jdmytrva/PowerSupply-BatteryCheking-PS2403L-/Eagle board/PS TPS54340 Voltage CurrentRev2.brd

## EAGLE design Eagle board/PS TPS54340 Voltage CurrentRev2.brd (2019-05-19, an earlier design)

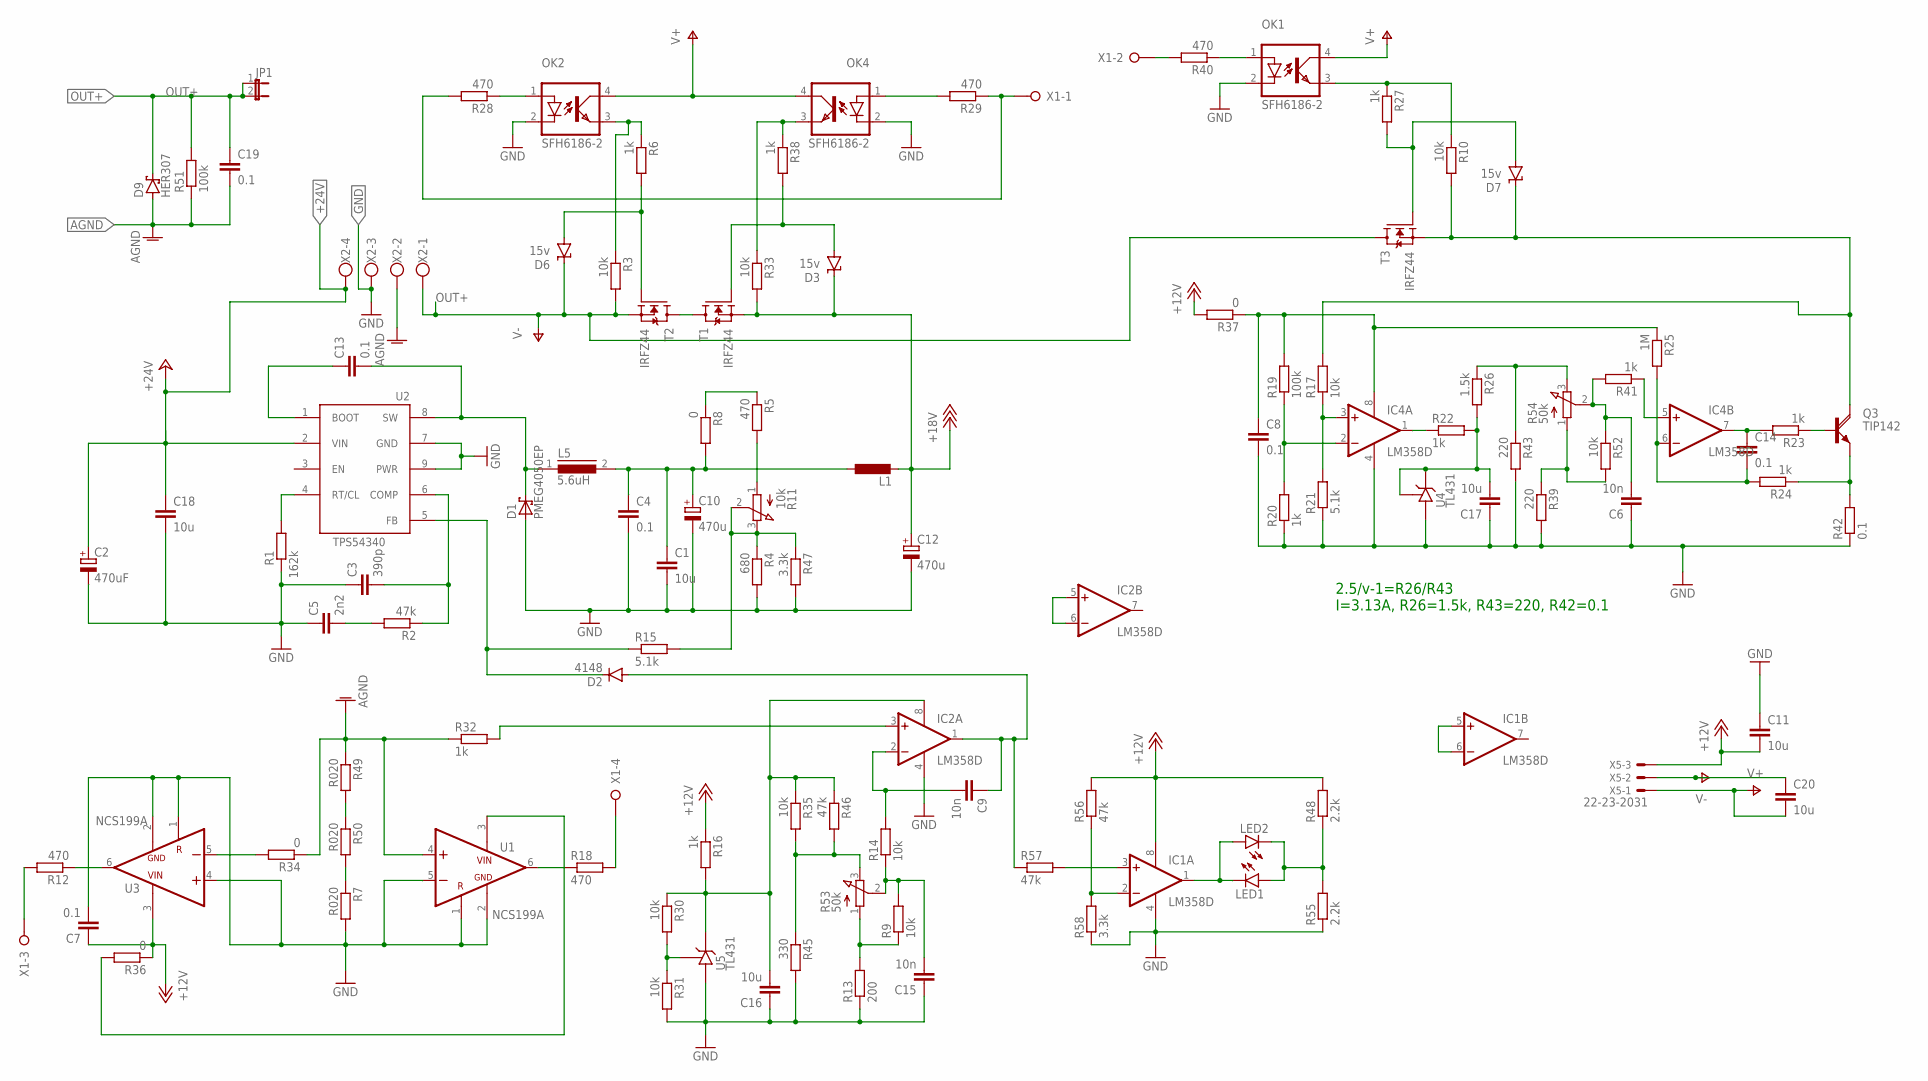
[picture p1: schematic PS TPS54340 Voltage CurrentRev2.sch]

Parts:
C1, C18: 10u; C1210
C2: 470uF; E5-10,5
C3: 390p; C0603K
C4, C8, C14: 0.1; C1206
C5: 2n2; C0603K
C6, C9, C15: 10n; C0603K
C7: 0.1; C0603K
C10, C12: 470u; E5-10,5
C11, C20: 10u; C1206
C13: 0.1; C102-043X133
C16, C17: 10u; C0603K
C19: 0.1; C150-054X183
D1: PMEG4050EP; SOD128
D2: 4148; SOD80C
D3, D6, D7: 15v; SMBJ
D9: HER307; CB429-17
IC1, IC2, IC4: LM358D; SO08
JP1: JP1E; JP1
L1: L-EU0207/5V; 0207/5V
L5: 5.6uH; DR125
LED1, LED2: LEDB152; Q62902-B152
OK1, OK2, OK4: SFH6186-2; SMD4-7
Q3: TIP142; SOT93
R1: 162k; R1206
R2, R46, R56, R57: 47k; R0603
R3, R9, R10, R30, R31, R33, R35, R52: 10k; R0603
R4: 680; R1206
R5: 470; R1206
R6, R16, R22, R27, R38: 1k; R0603
R7, R49, R50: R020; R1206
R8: 0; R0603
R11: 10k; 3RP/1610N
R12, R18, R28, R29, R40: 470; R0603
R13: 200; R0603
R14, R17: 10k; R1206
R15: 5.1k; R0603
R19: 100k; R1206
R20, R23, R24, R32, R41: 1k; R1206
R21: 5.1k; R1206
R25: 1M; R1206
R26: 1.5k; R0603
R34, R36, R37: 0; R1206
R39, R43: 220; R0603
R42: 0.1; 0414/15
R45: 330; R0603
R47: 3.3k; R1206
R48, R55: 2.2k; R0603
R51: 100k; 0207/15
R53, R54: 50k; 3RP/1610N
R58: 3.3k; R0603
T1, T2, T3: IRFZ44; DPAK_TO252
U1, U3: NCS199A; SOT363
U2: TPS54340; HSOP
U4, U5: TL431; SOT23
X1: W237-04P; W237-4P
X2: W237-4
X5: 22-23-2031

Connections:
+12V: C7.1, C11.2, IC1.8 (V+), R16.1, R36.1, R37.2, R48.2, R56.2, U3.3 (VCC), X5.3
+18V: C12.+, D3.C, L1.2, R33.2, T1.3 (S)
+24V: C2.+, C18.1, U2.2 (VIN), X2.4
AGND: C19.2, D9.A, R32.1, R34.1, R49.1, R51.1, U1.4 (IN+), X2.2
GND: C1.2, C2.-, C3.1, C4.2, C5.1, C6.1, C7.2, C8.2, C10.-, C11.1, C12.-, C15.1, C16.1, C17.1, C18.2, D1.2 (A), IC1.4 (V-), IC2.4 (V-), IC4.4 (V-), OK1.2 (C), OK2.2 (C), OK4.2 (C), R1.1, R4.2, R7.2, R13.1, R20.1, R21.1, R31.2, R39.2, R42.1, R43.2, R45.2, R47.2, R55.1, R58.1, U1.1 (REF), U1.2 (GND), U1.5 (IN-), U2.7 (GND), U2.9 (PWR), U3.1 (REF), U3.2 (GND), U3.4 (IN+), U4.3 (A), U5.3 (A), X2.3
unnamed: R1.2, U2.4 (RT/CL)
unnamed: C5.2, R2.2
unnamed: C3.2, R2.1, U2.6 (COMP)
unnamed: R5.2, R11.1 (A)
unnamed: D6.A, R6.2, T2.1 (G)
unnamed: IC2.3 (+IN), R32.2
unnamed: R4.1, R11.2 (S), R11.3 (E), R15.2, R47.1
unnamed: C16.2, IC2.8 (V+), R16.2, R30.1, R35.1, R46.1, U5.1 (C)
unnamed: OK2.3 (EMIT), R3.1, R6.1
unnamed: D3.A, R38.2, T1.1 (G)
unnamed: C13.1, U2.1 (BOOT)
unnamed: C13.2, D1.1 (K), L5.1, U2.8 (SW)
unnamed: R12.1, U3.6 (OUT)
unnamed: C9.2, IC2.2 (-IN), R14.2
unnamed: R30.2, R31.1, U5.2 (R)
unnamed: C9.1, D2.A, IC2.1 (OUT), R57.1
unnamed: C15.2, R9.2, R14.1, R53.2 (S)
unnamed: R34.2, U3.5 (IN-)
unnamed: D2.C, R15.1, U2.5 (FB)
unnamed: R18.1, U1.6 (OUT)
unnamed: T1.2 (D), T2.2 (D)
unnamed: IC1.1 (OUT), LED1.K (C), LED2.A
unnamed: C1.1, C4.1, C10.+, L1.1, L5.2, R8.2
unnamed: Q3.B, R23.1
unnamed: OK1.1 (A), R40.1
unnamed: C14.2, IC4.6 (-IN), R24.2, R25.2
unnamed: R26.1, R43.1, R54.3 (E)
unnamed: D7.C, Q3.C, R10.2, R17.2, T3.3 (S)
unnamed: OK1.3 (EMIT), R10.1, R27.1
unnamed: LED1.A, LED2.K (C), R48.1, R55.2
unnamed: R35.2, R45.1, R46.2, R53.3 (E)
unnamed: IC4.5 (+IN), R41.1
unnamed: IC1.2 (-IN), R56.1, R58.2
unnamed: R36.2, U1.3 (VCC)
unnamed: R18.2, X1.4
unnamed: R12.2, X1.3
unnamed: D7.A, R27.2, T3.1 (G)
unnamed: R39.1, R52.2, R54.1 (A)
unnamed: C8.1, IC4.8 (V+), R19.2, R25.1, R37.1
unnamed: R40.2, X1.2
unnamed: R9.1, R13.2, R53.1 (A)
unnamed: R49.2, R50.1
unnamed: IC2.5 (+IN), IC2.6 (-IN)
unnamed: IC1.3 (+IN), R57.2
unnamed: IC1.5 (+IN), IC1.6 (-IN)
unnamed: R7.1, R50.2
unnamed: OK4.3 (EMIT), R33.1, R38.1
unnamed: OK4.1 (A), R29.2
unnamed: R28.2, R29.1, X1.1
unnamed: OK2.1 (A), R28.1
unnamed: C17.2, R22.2, R26.2, U4.1 (C), U4.2 (R)
unnamed: R5.1, R8.1
unnamed: Q3.E, R24.1, R42.2
unnamed: C14.1, IC4.7 (OUT), R23.2
unnamed: C6.2, R41.2, R52.1, R54.2 (S)
unnamed: IC4.1 (OUT), R22.1
unnamed: IC4.3 (+IN), R17.1, R21.2
unnamed: IC4.2 (-IN), R19.1, R20.2
OUT+: C19.1, C20.1, D6.C, D9.C, JP1.1, JP1.2, R3.2, R51.2, T2.3 (S), T3.2 (D), X2.1, X5.2
V+: C20.2, OK1.4 (COL), OK2.4 (COL), OK4.4 (COL), X5.1

Notes on the sheet:
2.5/v-1=R26/R43 I=3.13A, R26=1.5k, R43=220, R42=0.1

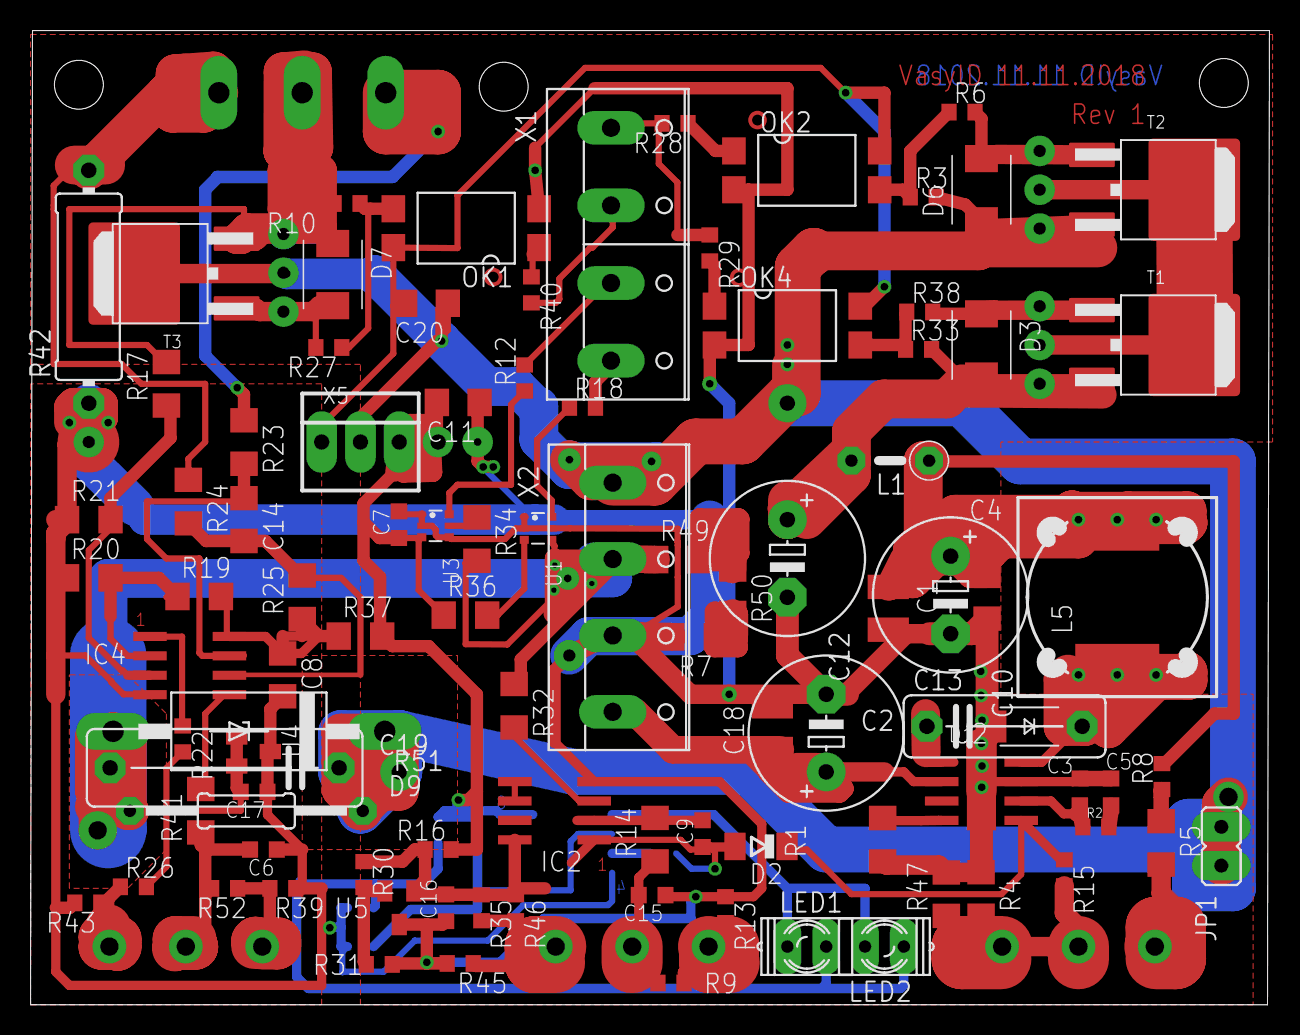
[picture p2: board PS TPS54340 Voltage CurrentRev2.brd from above]

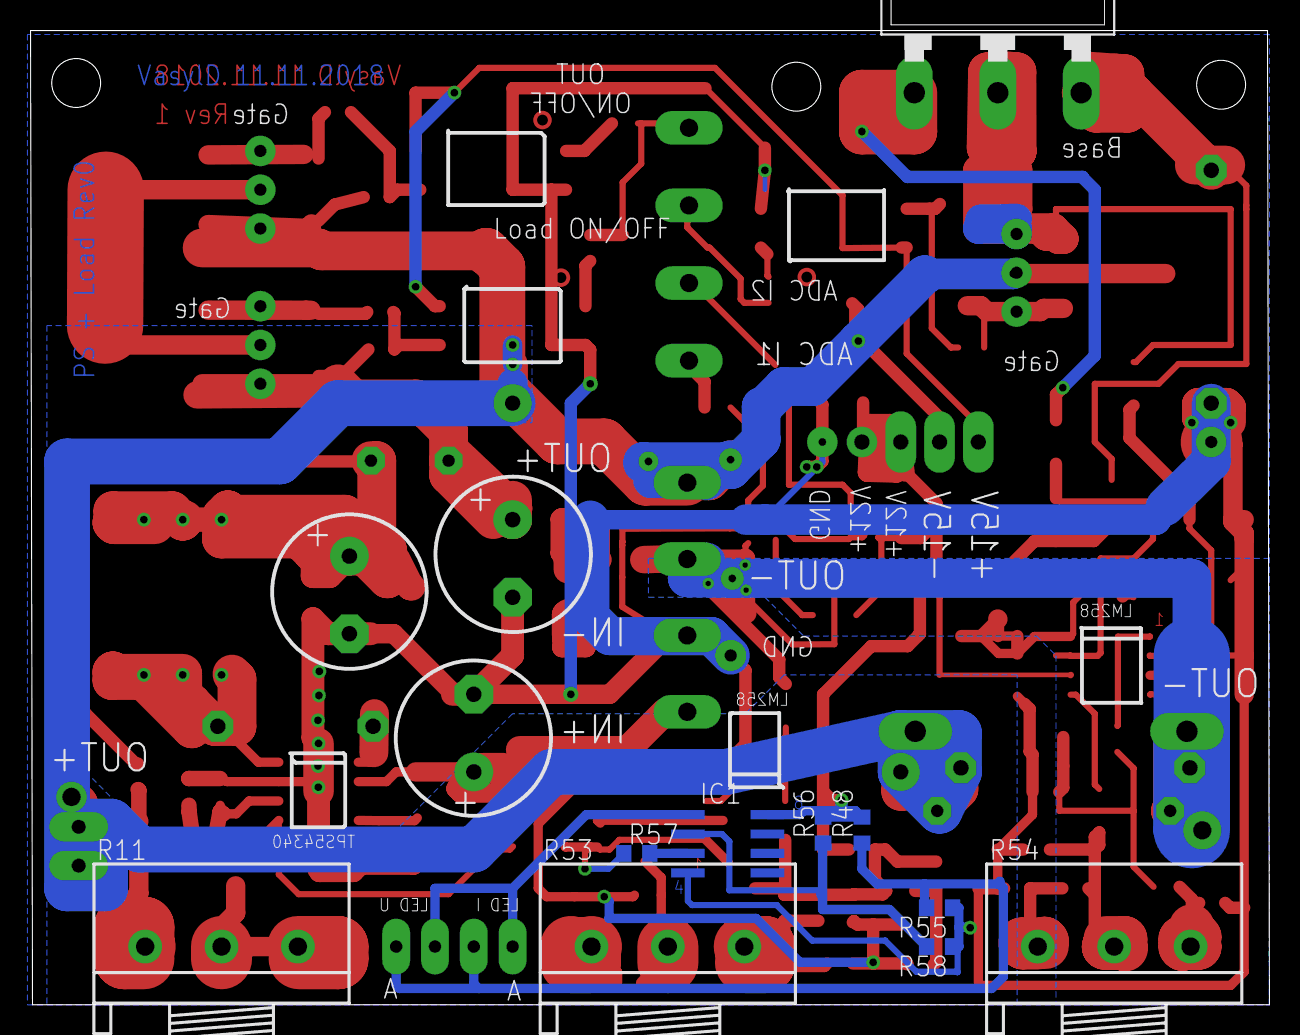
[picture p3: board PS TPS54340 Voltage CurrentRev2.brd from below]

Board: 2 copper layers, 81.1 x 63.8 mm, 106 parts (10 on the bottom side), 65 nets.
