jdmytrva/PowerSupply-BatteryCheking-PS2403L-/Eagle board/LCD&ControlRev1Fix1.brd

## EAGLE design Eagle board/LCD&ControlRev1Fix1.brd (2019-05-19, last stored version)

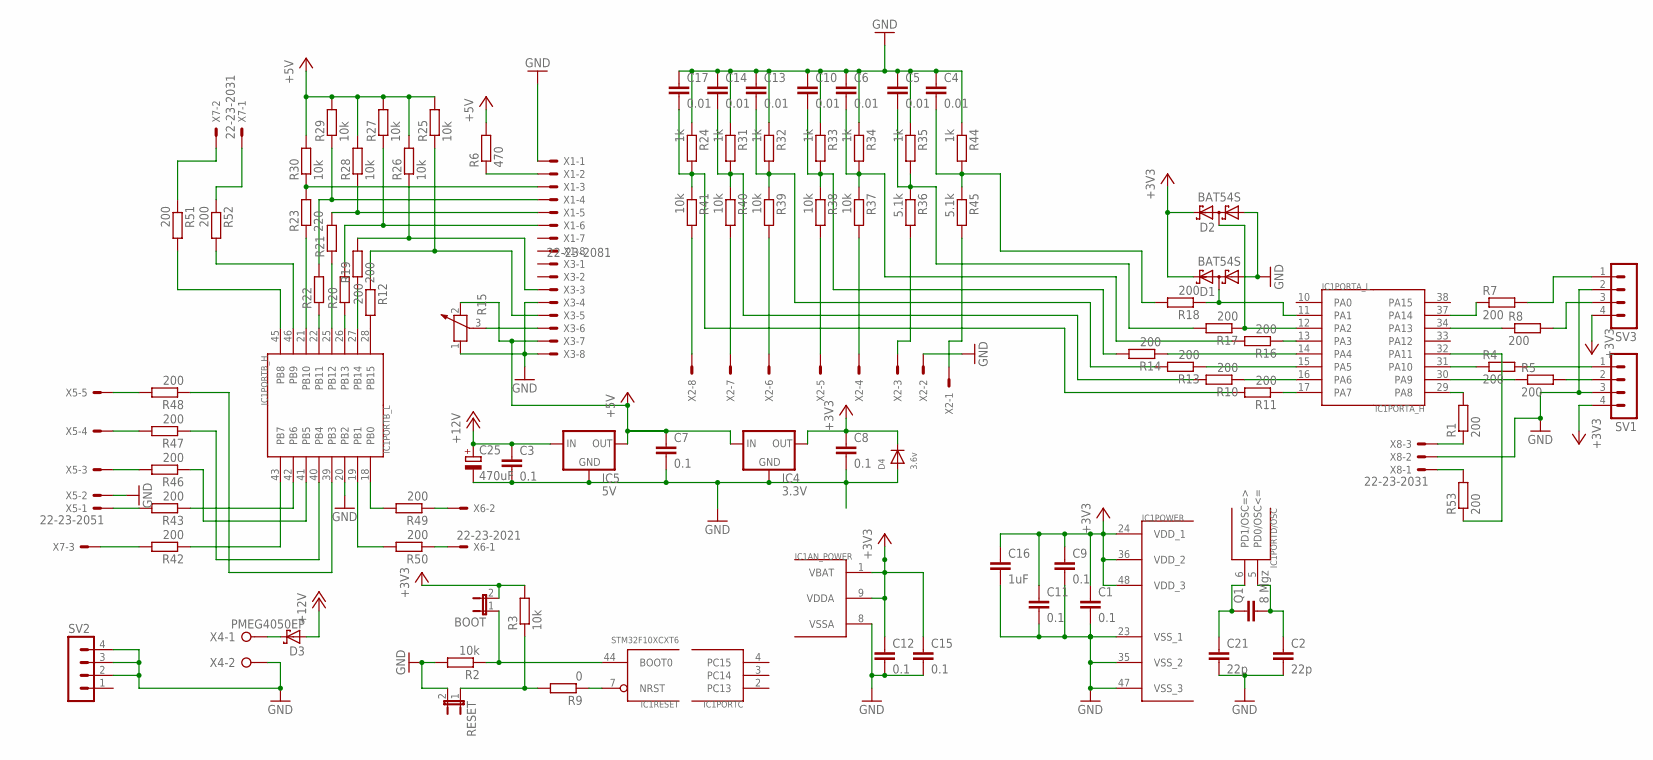
[picture p4: schematic LCD&ControlRev1Fix1.sch]

Parts:
BOOT: JP1E; JP1
C1, C9, C11, C12, C15: 0.1; C0402
C2, C21: 22p; C0603
C3, C7, C8: 0.1; C1206
C4, C5, C6, C10, C13, C14, C17: 0.01; C0603
C16: 1uF; C0603
C25: 470uF; E5-10,5
D1, D2: BAT54S; SOT23
D3: PMEG4050EP; SOD128
D4: 3.6v; SOD-123
IC1: STM32F10XCXT6; TQFP48
IC4: 3.3V; SOT223
IC5: 5V; SOT223
Q1: 8 Mgz; C050-024X044
R1, R4, R5, R7, R8, R10, R11, R13, R14, R16, R17, R18, R19, R42, R43, R46, R47, R48, R49, R50, R51, R52, R53: 200; R0603
R2, R25, R26, R27, R28, R29, R30, R37, R38, R39, R40, R41: 10k; R0603
R3: 10k; M1206
R6: 470; R0603
R9: 0; M1206
R12: 200; M1206
R15: POTENTIOMETER_PT-10S; PT-10S
R20, R21, R22: R-EU_R0603; R0603
R23: 220; R0603
R24, R31, R32, R33, R34, R35, R44: 1k; R0603
R36, R45: 5.1k; R0603
RESET: JP1E; JP1
SV1, SV2, SV3: MA04-1
X1, X2, X3: 22-23-2081
X4: W237-02P; W237-132
X5: 22-23-2051
X6: 22-23-2021
X7, X8: 22-23-2031

Connections:
+3V3: BOOT.2, C1.1, C8.1, C9.1, C11.1, C12.1, C15.1, C16.1, D1.2 (C2), D2.2 (C2), D4.C, IC1.1 (VBAT), IC1.9 (VDDA), IC1.24 (VDD_1), IC1.36 (VDD_2), IC1.48 (VDD_3), IC4.2 (OUT), IC4.4 (OUT), R3.2, SV1.4, SV3.4
+5V: C7.1, IC4.3 (IN), IC5.2 (OUT), IC5.4 (OUT), R6.2, R15.2, R25.2, R26.2, R27.2, R28.2, R29.2, R30.2, X3.7
+12V: C3.1, C25.+, D3.2 (A), IC5.3 (IN)
GND: C1.2, C2.2, C3.2, C4.1, C5.1, C6.1, C7.2, C8.2, C9.2, C10.1, C11.2, C12.2, C13.1, C14.1, C15.2, C16.2, C17.1, C21.2, C25.-, D1.1 (A1), D2.1 (A1), D4.A, IC1.8 (VSSA), IC1.20 (PB2), IC1.23 (VSS_1), IC1.35 (VSS_2), IC1.47 (VSS_3), IC4.1 (GND), IC5.1 (GND), R2.2, R15.1, R24.1, R31.1, R32.1, R33.1, R34.1, R35.1, R44.1, RESET.2, SV1.3, SV2.2, SV2.3, SV2.4, SV3.2, X1.1, X2.2, X3.4, X3.8, X4.2, X5.2, X8.2
unnamed: IC1.29 (PA8), R1.2
unnamed: C21.1, IC1.6 (PD1/OSC=>), Q1.1
unnamed: C2.1, IC1.5 (PD0/OSC<=), Q1.2
unnamed: IC1.37 (PA14), R7.1
unnamed: IC1.34 (PA13), R8.1
unnamed: R7.2, SV3.1
unnamed: R3.1, R9.2, RESET.1
unnamed: IC1.7 (NRST), R9.1
unnamed: IC1.31 (PA10), R4.1
unnamed: IC1.30 (PA9), R5.1
unnamed: R4.2, SV1.1
unnamed: R6.1, X1.2
unnamed: R15.3, X3.6
unnamed: D3.1 (K), X4.1
unnamed: R22.2, R29.1, X1.4
unnamed: C17.2, R11.2, R24.2, R41.1
unnamed: R52.1, X7.1
unnamed: R1.1, X8.3
unnamed: IC1.46 (PB9), R52.2
unnamed: R43.2, X5.1
unnamed: R21.2, R28.1, X1.5
unnamed: D1.3 (C1A2), IC1.11 (PA1), R18.1
unnamed: R20.2, R27.1, X1.6
unnamed: R19.2, R26.1, X3.3
unnamed: R23.2, R30.1, X1.3
unnamed: R12.1, R25.1, X3.5
unnamed: IC1.21 (PB10), R23.1
unnamed: IC1.22 (PB11), R22.1
unnamed: IC1.25 (PB12), R21.1
unnamed: IC1.45 (PB8), R51.2
unnamed: R47.2, X5.4
unnamed: R5.2, SV1.2
unnamed: R46.2, X5.3
unnamed: R48.2, X5.5
unnamed: R51.1, X7.2
unnamed: R8.2, SV3.3
unnamed: IC1.18 (PB0), R49.2
unnamed: IC1.43 (PB7), R42.1
unnamed: D2.3 (C1A2), IC1.12 (PA2), R17.1
unnamed: BOOT.1, IC1.44 (BOOT0), R2.1
unnamed: R42.2, X7.3
unnamed: IC1.42 (PB6), R43.1
unnamed: C14.2, R10.2, R31.2, R40.1
unnamed: C13.2, R13.2, R32.2, R39.1
unnamed: R38.2, X2.5
unnamed: IC1.13 (PA3), R16.1
unnamed: IC1.19 (PB1), R50.2
unnamed: IC1.14 (PA4), R14.1
unnamed: C6.2, R16.2, R34.2, R37.1
unnamed: C5.2, R17.2, R35.2, R36.1
unnamed: IC1.26 (PB13), R20.1
unnamed: IC1.27 (PB14), R19.1
unnamed: IC1.28 (PB15), R12.2
unnamed: R49.1, X6.2
unnamed: IC1.15 (PA5), R13.1
unnamed: IC1.16 (PA6), R10.1
unnamed: R45.2, X2.1
unnamed: IC1.41 (PB5), R46.1
unnamed: IC1.17 (PA7), R11.1
unnamed: R50.1, X6.1
unnamed: IC1.40 (PB4), R47.1
unnamed: IC1.39 (PB3), R48.1
unnamed: C4.2, R18.2, R44.2, R45.1
unnamed: R36.2, X2.3
unnamed: R37.2, X2.4
unnamed: R53.2, X8.1
unnamed: IC1.32 (PA11), R53.1
unnamed: C10.2, R14.2, R33.2, R38.1
unnamed: R39.2, X2.6
unnamed: R40.2, X2.7
unnamed: R41.2, X2.8

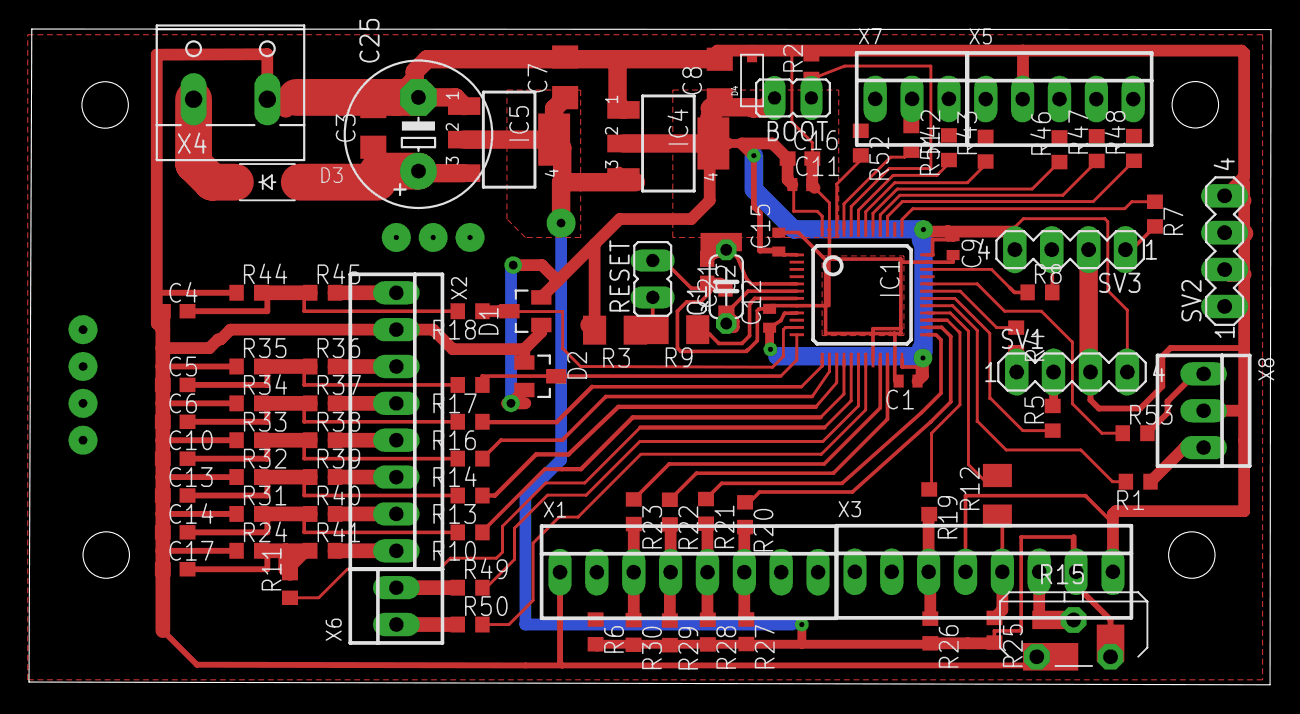
[picture p5: board LCD&ControlRev1Fix1.brd from above]

Board: 2 copper layers, 85.6 x 45.2 mm, 93 parts (0 on the bottom side), 75 nets.
