jdmytrva/PowerSupply-BatteryCheking-PS2403L-/Eagle board/Rectifier+different voltages.brd

## EAGLE design Eagle board/Rectifier+different voltages.brd (2019-05-19, last stored version)

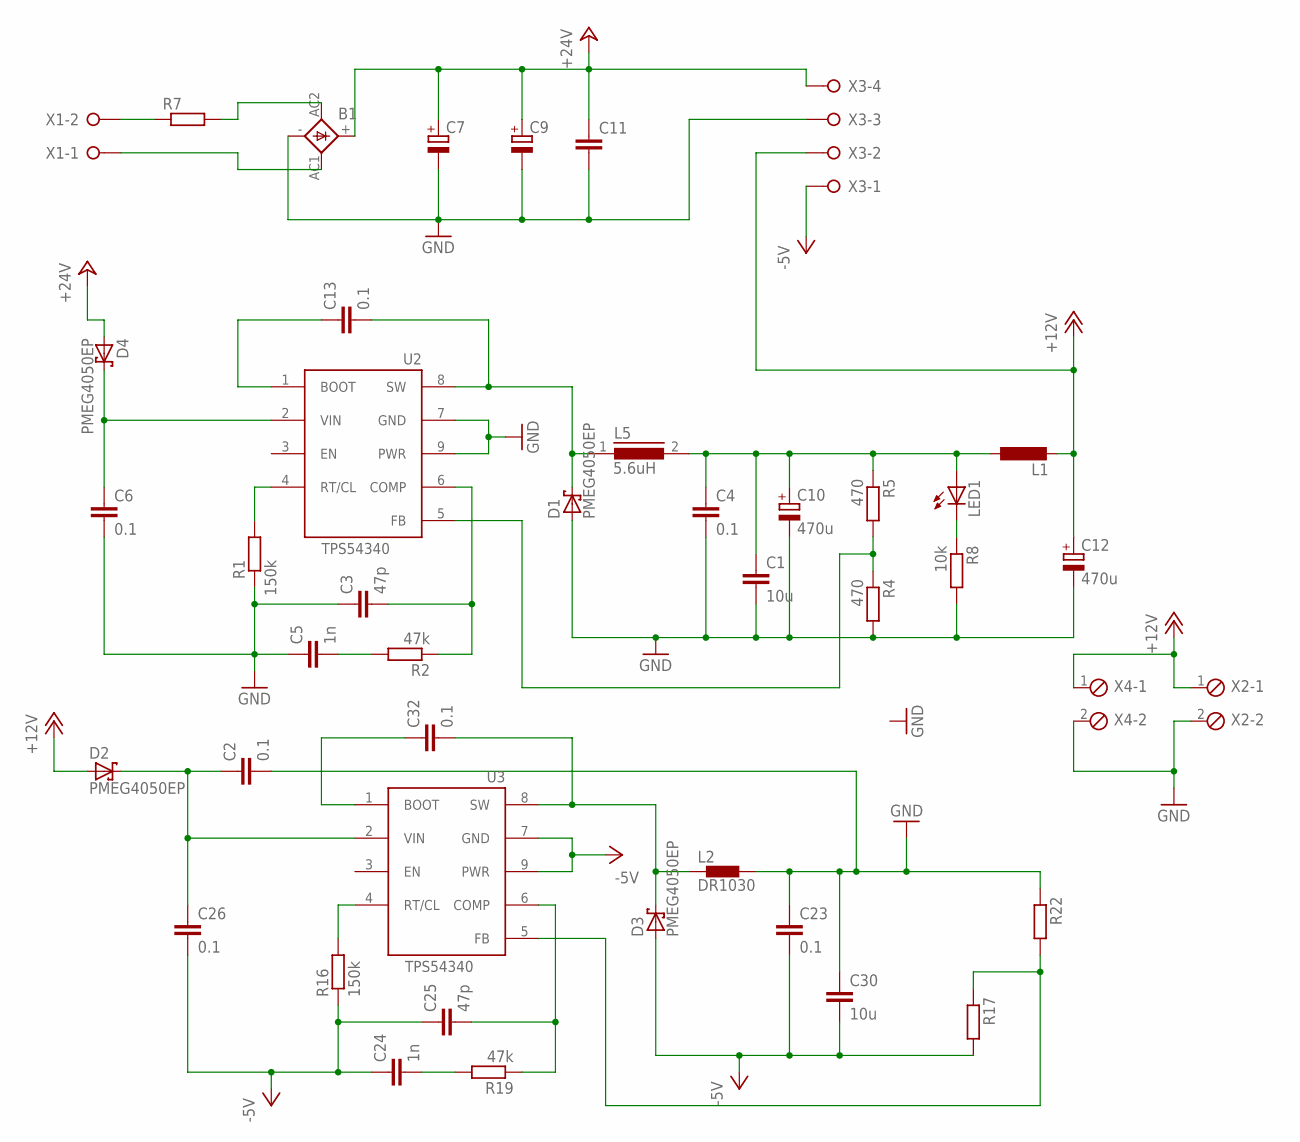
[picture p6: schematic Rectifier+different voltages.sch]

Parts:
B1: KBL
C1, C30: 10u; C1206
C2, C26: 0.1; C1210
C3, C25: 47p; C0603K
C4, C6, C23: 0.1; C1206
C5, C24: 1n; C0603K
C7, C9: CPOL-EUE7.5-18; E7,5-18
C10, C12: 470u; E5-10,5
C11: C-EUC1206; C1206
C13: 0.1; C102-043X133
C32: 0.1; C075-032X103
D1, D2, D3, D4: PMEG4050EP; SOD128
L1: L-EU0207/5V; 0207/5V
L2: DR1030
L5: 5.6uH; DR125
LED1: LEDB152; Q62902-B152
R1, R16: 150k; R1206
R2, R19: 47k; R0603
R4, R5: 470; R1206
R7: R-EU_0207/10; 0207/10
R8: 10k; R0603
R17, R22: R-EU_R1206; R1206
U2: TPS54340; HSOP
U3: TPS54340SO8; HSOP
X1: W237-02P; W237-132
X2, X4: MPT2; 2POL254
X3: W237-04P; W237-4P

Connections:
+12V: C12.+, D2.2 (A), L1.2, X2.1, X3.2, X4.1
+24V: B1.+, C7.+, C9.+, C11.1, D4.2 (A), X3.4
-5V: C23.2, C24.1, C25.1, C26.2, C30.2, D3.2 (A), R16.1, R17.2, U3.7 (GND), U3.9 (PWR), X3.1
GND: B1.-, C1.2, C2.2, C3.1, C4.2, C5.1, C6.2, C7.-, C9.-, C10.-, C11.2, C12.-, C23.1, C30.1, D1.2 (A), L2.2, R1.1, R4.2, R8.2, R22.1, U2.7 (GND), U2.9 (PWR), X2.2, X3.3, X4.2
unnamed: R1.2, U2.4 (RT/CL)
unnamed: C5.2, R2.2
unnamed: C3.2, R2.1, U2.6 (COMP)
unnamed: R7.1, X1.2
unnamed: R4.1, R5.2, U2.5 (FB)
unnamed: LED1.K (C), R8.1
unnamed: C2.1, C26.1, D2.1 (K), U3.2 (VIN)
unnamed: C6.1, D4.1 (K), U2.2 (VIN)
unnamed: C13.1, U2.1 (BOOT)
unnamed: C13.2, D1.1 (K), L5.1, U2.8 (SW)
unnamed: B1.AC1 (AC2), X1.1
unnamed: B1.AC2 (AC1), R7.2
unnamed: R17.1, R22.2, U3.5 (FB)
unnamed: R16.2, U3.4 (RT/CL)
unnamed: C25.2, R19.1, U3.6 (COMP)
unnamed: C1.1, C4.1, C10.+, L1.1, L5.2, LED1.A, R5.1
unnamed: C32.1, U3.1 (BOOT)
unnamed: C32.2, D3.1 (K), L2.1, U3.8 (SW)
unnamed: C24.2, R19.2

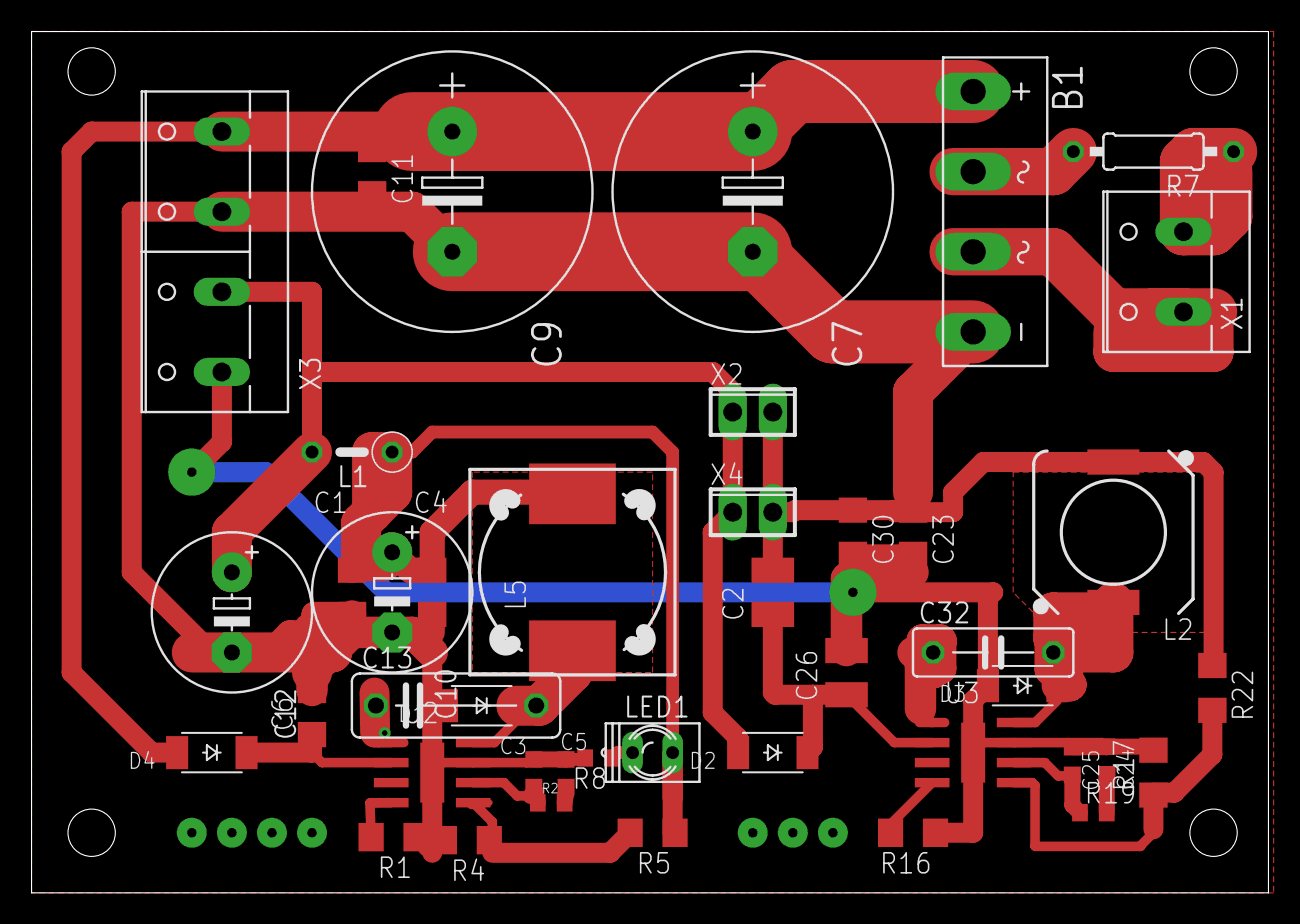
[picture p7: board Rectifier+different voltages.brd from above]

Board: 2 copper layers, 78.4 x 54.6 mm, 43 parts (0 on the bottom side), 23 nets.
