jdmytrva/PowerSupply-BatteryCheking-PS2403L-/Eagle board/LCD&Control2PRNT.brd

## EAGLE design Eagle board/LCD&Control2PRNT.brd (2019-05-19, last stored version)

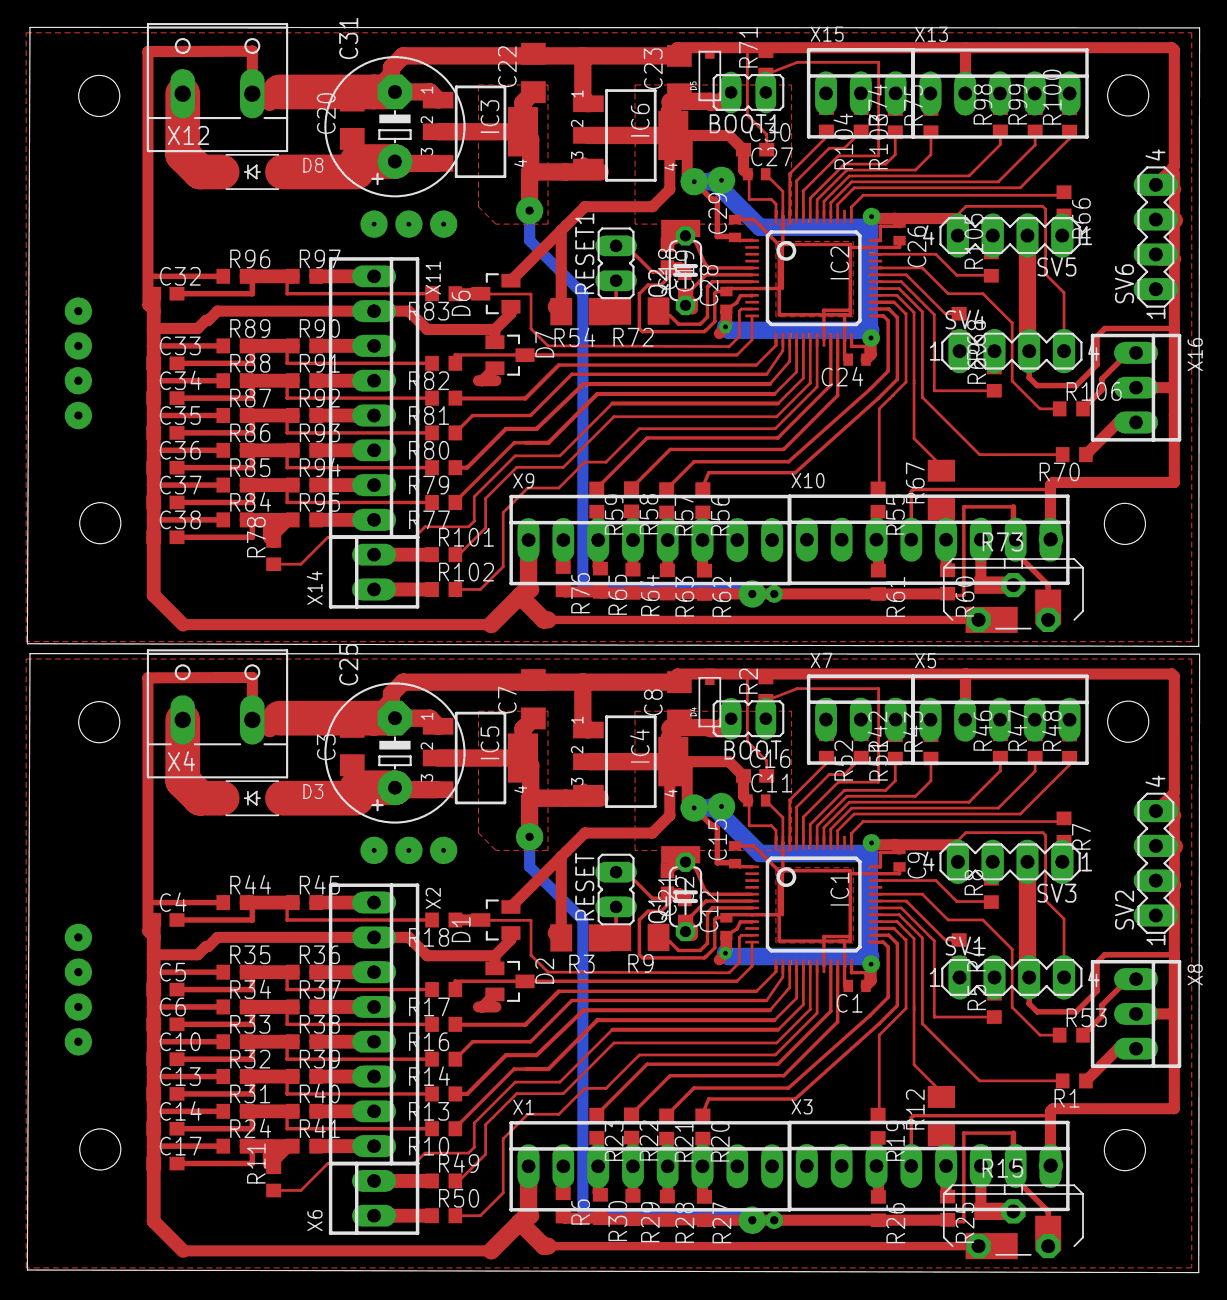
[picture p8: board LCD&Control2PRNT.brd from above]

Board: 2 copper layers, 85.6 x 90.9 mm, 186 parts (0 on the bottom side), 150 nets.

Parts:
BOOT, BOOT1: JP1
C1, C9, C11, C12, C15, C24, C26, C27, C28, C29: 0.1; C0402
C2, C18, C19, C21: 22p; C0603
C3, C7, C8, C20, C22, C23: 0.1; C1206
C4, C5, C6, C10, C13, C14, C17, C32, C33, C34, C35, C36, C37, C38: C0603
C16, C30: 1uF; C0603
C25, C31: 470uF; E5-10,5
D1, D2, D6, D7: BAT54S; SOT23
D3, D8: PMEG4050EP; SOD128
D4, D5: 3.6v; SOD-123
IC1, IC2: STM32F10XCXT6; TQFP48
IC3, IC5: 5V; SOT223
IC4, IC6: 3.3V; SOT223
Q1, Q2: 8 Mgz; C050-024X044
R1, R4, R5, R7, R8, R10, R11, R13, R14, R16, R17, R18, R19, R24, R31, R32, R33, R34, R35, R36, R37, R38, R39, R40, R41, R42, R43, R44, R45, R46, R47, R48, R49, R50, R51, R52, R53, R55, R66, R68, R69, R70, R74, R75, R77, R78, R79, R80, R81, R82, R83, R84, R85, R86, R87, R88, R89, R90, R91, R92, R93, R94, R95, R96, R97, R98, R99, R100, R101, R102, R103, R104, R105, R106: 200; R0603
R2, R25, R26, R27, R28, R29, R30, R60, R61, R62, R63, R64, R65, R71: 10k; R0603
R3, R54: 10k; M1206
R6, R76: 470; R0603
R9, R72: 0; M1206
R12, R67: 200; M1206
R15, R73: PT-10S
R20, R21, R22, R56, R57, R58: R0603
R23, R59: 220; R0603
RESET, RESET1: JP1
SV1, SV2, SV3, SV4, SV5, SV6: MA04-1
X1, X2, X3, X9, X10, X11: 22-23-2081
X4, X12: W237-132
X5, X13: 22-23-2051
X6, X14: 22-23-2021
X7, X8, X15, X16: 22-23-2031

Connections:
+3V1: BOOT1.2, C23.1, C24.1, C26.1, C27.1, C28.1, C29.1, C30.1, D5.C, D6.2, D7.2, IC2.1, IC2.9, IC2.24, IC2.36, IC2.48, IC6.2, IC6.4, R54.2, SV4.4, SV5.4
+3V3: BOOT.2, C1.1, C8.1, C9.1, C11.1, C12.1, C15.1, C16.1, D1.2, D2.2, D4.C, IC1.1, IC1.9, IC1.24, IC1.36, IC1.48, IC4.2, IC4.4, R3.2, SV1.4, SV3.4
+5V: C7.1, IC4.3, IC5.2, IC5.4, R6.2, R15.2, R25.2, R26.2, R27.2, R28.2, R29.2, R30.2, X3.7
+5V1: C22.1, IC3.2, IC3.4, IC6.3, R60.2, R61.2, R62.2, R63.2, R64.2, R65.2, R73.2, R76.2, X10.7
+12V: C3.1, C25.+, D3.2, IC5.3
+12V1: C20.1, C31.+, D8.2, IC3.3
GND: C1.2, C2.2, C3.2, C4.1, C5.1, C6.1, C7.2, C8.2, C9.2, C10.1, C11.2, C12.2, C13.1, C14.1, C15.2, C16.2, C17.1, C21.2, C25.-, D1.1, D2.1, D4.A, IC1.8, IC1.20, IC1.23, IC1.35, IC1.47, IC4.1, IC5.1, R2.2, R15.1, R24.1, R31.1, R32.1, R33.1, R34.1, R35.1, R44.1, RESET.2, SV1.3, SV2.2, SV2.3, SV2.4, SV3.2, X1.1, X2.2, X3.4, X3.8, X4.2, X5.2, X8.2
GND1: C18.2, C19.2, C20.2, C22.2, C23.2, C24.2, C26.2, C27.2, C28.2, C29.2, C30.2, C31.-, C32.1, C33.1, C34.1, C35.1, C36.1, C37.1, C38.1, D5.A, D6.1, D7.1, IC2.8, IC2.20, IC2.23, IC2.35, IC2.47, IC3.1, IC6.1, R71.2, R73.1, R84.1, R85.1, R86.1, R87.1, R88.1, R89.1, R96.1, RESET1.2, SV4.3, SV5.2, SV6.2, SV6.3, SV6.4, X9.1, X10.4, X10.8, X11.2, X12.2, X13.2, X16.2
unnamed: IC1.29, R1.2
unnamed: C21.1, IC1.6, Q1.1
unnamed: C2.1, IC1.5, Q1.2
unnamed: IC1.37, R7.1
unnamed: IC1.34, R8.1
unnamed: R7.2, SV3.1
unnamed: R3.1, R9.2, RESET.1
unnamed: IC1.7, R9.1
unnamed: IC1.31, R4.1
unnamed: IC1.30, R5.1
unnamed: R4.2, SV1.1
unnamed: R6.1, X1.2
unnamed: R15.3, X3.6
unnamed: D3.1, X4.1
unnamed: R22.2, R29.1, X1.4
unnamed: C17.2, R11.2, R24.2, R41.1
unnamed: R52.1, X7.1
unnamed: R1.1, X8.3
unnamed: IC1.46, R52.2
unnamed: R43.2, X5.1
unnamed: R21.2, R28.1, X1.5
unnamed: D1.3, IC1.11, R18.1
unnamed: R20.2, R27.1, X1.6
unnamed: R19.2, R26.1, X3.3
unnamed: R23.2, R30.1, X1.3
unnamed: R12.1, R25.1, X3.5
unnamed: IC1.21, R23.1
unnamed: IC1.22, R22.1
unnamed: IC1.25, R21.1
unnamed: IC1.45, R51.2
unnamed: R47.2, X5.4
unnamed: R5.2, SV1.2
unnamed: R46.2, X5.3
unnamed: R48.2, X5.5
unnamed: R51.1, X7.2
unnamed: R8.2, SV3.3
unnamed: IC1.18, R49.2
unnamed: IC1.43, R42.1
unnamed: D2.3, IC1.12, R17.1
unnamed: BOOT.1, IC1.44, R2.1
unnamed: R42.2, X7.3
unnamed: IC1.42, R43.1
unnamed: C14.2, R10.2, R31.2, R40.1
unnamed: C13.2, R13.2, R32.2, R39.1
unnamed: R38.2, X2.5
unnamed: IC1.13, R16.1
unnamed: IC1.19, R50.2
unnamed: IC1.14, R14.1
unnamed: C6.2, R16.2, R34.2, R37.1
unnamed: C5.2, R17.2, R35.2, R36.1
unnamed: IC1.26, R20.1
unnamed: IC1.27, R19.1
unnamed: IC1.28, R12.2
unnamed: R49.1, X6.2
unnamed: IC1.15, R13.1
unnamed: IC1.16, R10.1
unnamed: R45.2, X2.1
unnamed: IC1.41, R46.1
unnamed: IC1.17, R11.1
unnamed: R50.1, X6.1
unnamed: IC1.40, R47.1
unnamed: IC1.39, R48.1
unnamed: C4.2, R18.2, R44.2, R45.1
unnamed: R36.2, X2.3
unnamed: R37.2, X2.4
unnamed: R53.2, X8.1
unnamed: IC1.32, R53.1
unnamed: C10.2, R14.2, R33.2, R38.1
unnamed: R39.2, X2.6
unnamed: C18.1, IC2.6, Q2.1
unnamed: C19.1, IC2.5, Q2.2
unnamed: R59.2, R65.1, X9.3
unnamed: R40.2, X2.7
unnamed: BOOT1.1, IC2.44, R71.1
unnamed: R58.2, R64.1, X9.4
unnamed: R57.2, R63.1, X9.5
unnamed: R56.2, R62.1, X9.6
unnamed: R55.2, R61.1, X10.3
unnamed: R60.1, R67.1, X10.5
unnamed: IC2.21, R59.1
unnamed: R41.2, X2.8
unnamed: IC2.22, R58.1
unnamed: IC2.25, R57.1
unnamed: IC2.26, R56.1
unnamed: IC2.27, R55.1
unnamed: IC2.28, R67.2
unnamed: IC2.34, R105.1
unnamed: IC2.31, R68.1
unnamed: IC2.30, R69.1
unnamed: R68.2, SV4.1
unnamed: R69.2, SV4.2
unnamed: R66.2, SV5.1
unnamed: IC2.37, R66.1
unnamed: R105.2, SV5.3
unnamed: R54.1, R72.2, RESET1.1
unnamed: R76.1, X9.2
unnamed: IC2.29, R70.2
unnamed: IC2.7, R72.1
unnamed: R73.3, X10.6
unnamed: D6.3, IC2.11, R83.1
unnamed: D7.3, IC2.12, R82.1
unnamed: IC2.13, R81.1
unnamed: IC2.14, R80.1
unnamed: IC2.15, R79.1
unnamed: IC2.16, R77.1
unnamed: IC2.17, R78.1
unnamed: C38.2, R78.2, R84.2, R95.1
unnamed: C37.2, R77.2, R85.2, R94.1
unnamed: C36.2, R79.2, R86.2, R93.1
unnamed: R92.2, X11.5
unnamed: C34.2, R81.2, R88.2, R91.1
unnamed: C33.2, R82.2, R89.2, R90.1
unnamed: R97.2, X11.1
unnamed: C32.2, R83.2, R96.2, R97.1
unnamed: R90.2, X11.3
unnamed: R91.2, X11.4
unnamed: C35.2, R80.2, R87.2, R92.1
unnamed: R93.2, X11.6
unnamed: R94.2, X11.7
unnamed: R95.2, X11.8
unnamed: D8.1, X12.1
unnamed: R98.2, X13.3
unnamed: R99.2, X13.4
unnamed: R100.2, X13.5
unnamed: IC2.43, R74.1
unnamed: IC2.42, R75.1
unnamed: IC2.41, R98.1
unnamed: IC2.40, R99.1
unnamed: IC2.39, R100.1
unnamed: IC2.18, R101.2
unnamed: IC2.19, R102.2
unnamed: R101.1, X14.2
unnamed: R102.1, X14.1
unnamed: IC2.46, R104.2
unnamed: IC2.45, R103.2
unnamed: IC2.32, R106.1
unnamed: R75.2, X13.1
unnamed: R104.1, X15.1
unnamed: R103.1, X15.2
unnamed: R74.2, X15.3
unnamed: R70.1, X16.3
unnamed: R106.2, X16.1
