jdmytrva/PowerSupply-BatteryCheking-PS2403L-/PS2403L/PS2403L.ioc

Mcu.UserName=STM32F100C8Tx
PA1.Signal=ADCx_IN1
PA10.Signal=USART1_RX
PA11.Signal=GPIO_Output
PA13.Signal=SYS_JTMS-SWDIO
PA14.Signal=SYS_JTCK-SWCLK
PA15.Signal=GPIO_Output
PA2.Signal=ADCx_IN2
PA3.Signal=ADCx_IN3
PA4.Signal=ADCx_IN4
PA5.Signal=ADCx_IN5
PA6.Signal=ADCx_IN6
PA8.Signal=GPIO_Output
PA9.Signal=USART1_TX
PB0.Signal=GPIO_Output
PB1.Signal=GPIO_Output
PB10.Signal=GPIO_Output
PB11.Signal=GPIO_Output
PB12.Signal=GPIO_Output
PB13.Signal=GPIO_Output
PB14.Signal=GPIO_Output
PB15.Signal=GPIO_Output
PB4.Signal=GPIO_Input
PB5.Signal=GPIO_Input
PB6.Signal=GPIO_Input
PB7.Signal=GPIO_Input
PD0-OSC_IN.Signal=RCC_OSC_IN
PD1-OSC_OUT.Signal=RCC_OSC_OUT
