jdmytrva/PowerSupply-BatteryCheking-PS2403L-/PS2403L/Core/Src/usart.c

#include "usart.h"





#define INTERUPT 0// 1 - yes, 0 - no




void printToBufferUART1(volatile char* str)//10us for one char 24Mgz
{
	//while (bufferUart1.tx_counter >= TX_BUFFER_SIZE-30); //если буфер переполнен, ждем

	//LL_USART_DisableIT_TXE(USART1); //запрещаем прерывание, чтобы оно не мешало менять переменную
	USART1->CR1 &= ~USART_CR1_TXEIE;  // Interrupt Disable

	while (*str != 0)
	{
		bufferUart1.tx_buffer[bufferUart1.tx_wr_index++]=*str++; //то кладем данные в буфер
		if (bufferUart1.tx_wr_index == TX_BUFFER_SIZE) bufferUart1.tx_wr_index=0; //идем по кругу
		++bufferUart1.tx_counter; //увеличиваем счетчик количества данных в буфере
		#if DEBUG_LEVEL
			if (bufferUart1.tx_buffer_overflow < bufferUart1.tx_counter)
				bufferUart1.tx_buffer_overflow = bufferUart1.tx_counter;
		#endif
	}
	bufferUart1.tx_buffer[bufferUart1.tx_wr_index++]='\n'; //то кладем данные в буфер
	if (bufferUart1.tx_wr_index == TX_BUFFER_SIZE) bufferUart1.tx_wr_index=0; //идем по кругу
	++bufferUart1.tx_counter; //увеличиваем счетчик количества данных в буфере
	#if DEBUG_LEVEL
		if (bufferUart1.tx_buffer_overflow < bufferUart1.tx_counter)
			bufferUart1.tx_buffer_overflow = bufferUart1.tx_counter;
	#endif

	//LL_USART_EnableIT_TXE(USART1); //разрешаем прерывание
	USART1->CR1 |= USART_CR1_TXEIE;// Interrupt enable
}


void printToBufferWithoutEndUART1(volatile char* str)//10us for one char 24Mgz
{
	//while (bufferUart1.tx_counter >= TX_BUFFER_SIZE-30); //если буфер переполнен, ждем

	//LL_USART_DisableIT_TXE(USART1); //запрещаем прерывание, чтобы оно не мешало менять переменную
	USART1->CR1 &= ~USART_CR1_TXEIE;  // Interrupt Disable

	while (*str != 0)
	{
		bufferUart1.tx_buffer[bufferUart1.tx_wr_index++]=*str++; //то кладем данные в буфер
		if (bufferUart1.tx_wr_index == TX_BUFFER_SIZE) bufferUart1.tx_wr_index=0; //идем по кругу
		++bufferUart1.tx_counter; //увеличиваем счетчик количества данных в буфере
		#if DEBUG_LEVEL
			if (bufferUart1.tx_buffer_overflow < bufferUart1.tx_counter)
				bufferUart1.tx_buffer_overflow = bufferUart1.tx_counter;
		#endif

	}
	USART1->CR1 |= USART_CR1_TXEIE;// Interrupt enable
}

void printToBufferUART1D(volatile char* str, volatile int32_t value, volatile uint8_t koma) //10us for one char + 6us for one digit 24Mgz
{
	char *str1;
	if (koma == 0)
		str1 = itoa(value);
	else
		str1 = itoa_koma(value,koma);

	//while (bufferUart1.tx_counter >= TX_BUFFER_SIZE-30); //если буфер переполнен, ждем

	//LL_USART_DisableIT_TXE(USART1); //запрещаем прерывание, чтобы оно не мешало менять переменную
	USART1->CR1 &= ~USART_CR1_TXEIE;  // Interrupt Disable

	while (*str != 0)
	{
		bufferUart1.tx_buffer[bufferUart1.tx_wr_index++]=*str++; //то кладем данные в буфер
		if (bufferUart1.tx_wr_index == TX_BUFFER_SIZE) bufferUart1.tx_wr_index=0; //идем по кругу
		++bufferUart1.tx_counter; //увеличиваем счетчик количества данных в буфере
		#if DEBUG_LEVEL
			if (bufferUart1.tx_buffer_overflow < bufferUart1.tx_counter)
				bufferUart1.tx_buffer_overflow = bufferUart1.tx_counter;
		#endif

	}

	while (*str1 != 0)
	{
		bufferUart1.tx_buffer[bufferUart1.tx_wr_index++]=*str1++; //то кладем данные в буфер
		if (bufferUart1.tx_wr_index == TX_BUFFER_SIZE) bufferUart1.tx_wr_index=0; //идем по кругу
		++bufferUart1.tx_counter; //увеличиваем счетчик количества данных в буфере
		#if DEBUG_LEVEL
			if (bufferUart1.tx_buffer_overflow < bufferUart1.tx_counter)
				bufferUart1.tx_buffer_overflow = bufferUart1.tx_counter;
		#endif

	}

	bufferUart1.tx_buffer[bufferUart1.tx_wr_index++]='\n'; //то кладем данные в буфер
	if (bufferUart1.tx_wr_index == TX_BUFFER_SIZE) bufferUart1.tx_wr_index=0; //идем по кругу
	++bufferUart1.tx_counter; //увеличиваем счетчик количества данных в буфере
	#if DEBUG_LEVEL
		if (bufferUart1.tx_buffer_overflow < bufferUart1.tx_counter)
			bufferUart1.tx_buffer_overflow = bufferUart1.tx_counter;
	#endif

	//LL_USART_EnableIT_TXE(USART1); //разрешаем прерывание
	USART1->CR1 |= USART_CR1_TXEIE;// Interrupt enable
}


void Print_to_USART1(volatile char *data)
{
#if INTERUPT
	putStringInBufferUart1(data);
	putCharInBufferUart1('\n');
#else
	putStringDirectToUart1(data);
	putCharDirectToUart1('\n');
#endif
}


void Print_to_USART1_d(volatile int32_t value,volatile char *string,uint8_t koma)
{
	char *str;

	if (koma == 0)
	{
		str = itoa(value);
	}
	else
		str = itoa_koma(value,koma);

#if INTERUPT
	putStringInBufferUart1(string);
	putStringInBufferUart1 (str);
	putCharInBufferUart1('\n');
#else
	putStringDirectToUart1(string);
	putStringDirectToUart1(str);
	putCharDirectToUart1('\n');
#endif
}


void putCharInBufferUart1(uint8_t c) //вывод данных
{
	//while (bufferUart1.tx_counter >= TX_BUFFER_SIZE); //если буфер переполнен, ждем
	LL_USART_DisableIT_TXE(USART1); //запрещаем прерывание, чтобы оно не мешало менять переменную
	bufferUart1.tx_buffer[bufferUart1.tx_wr_index++]=c; //то кладем данные в буфер
	if (bufferUart1.tx_wr_index == TX_BUFFER_SIZE)
		bufferUart1.tx_wr_index=0; //идем по кругу
	++bufferUart1.tx_counter; //увеличиваем счетчик количества данных в буфере
	#if DEBUG_LEVEL
		if (bufferUart1.tx_buffer_overflow < bufferUart1.tx_counter)
			bufferUart1.tx_buffer_overflow = bufferUart1.tx_counter;
	#endif

	LL_USART_EnableIT_TXE(USART1); //разрешаем прерывание

}
void putStringInBufferUart1(volatile char *s)
{
  while (*s != 0)
	  putCharInBufferUart1(*s++);
}

void putCharDirectToUart1(uint8_t c)
{
	while (!LL_USART_IsActiveFlag_TXE(USART1));
	LL_USART_TransmitData8(USART1, c);
	c++;
}

void putStringDirectToUart1(volatile char *s)
{
  while (*s != 0)
	  putCharDirectToUart1(*s++);
}
