jdmytrva/PowerSupply-BatteryCheking-PS2403L-/(commit log)

2019-06-03 PS 30V 3A v1.49
2019-06-03 PS 30V 3A v1.50
2019-06-03 PS 30V 3A v1.51
2019-06-04 PS 30V 3A v1.52 SergeyP
2019-06-04 PS 30V 3A v1.54
2019-06-04 PS 30V 3A v1.55
    Added new MenuSettingsSaveMenuPosWhenOFF
2019-06-05 PS 30V 3A v1.56
2019-06-24 PS 30V 3A v1.57
2019-06-25 PS 30V 3A v1.58
2019-06-25 PS 30V 3A v1.59
2019-06-25 PS 30V 3A v1.60
2019-07-10 v1.61. fixed swing, added attempt to read from eeprom
    [Eeprom.c, main.c]
2019-08-08 disable eeprom write when PowerOFF
2019-08-27 Added disable irq when write/read to flash. Save C when powerOff
2019-09-07 1.65 fixed interrupt priority
    [main.c]
2019-09-08 1.66 3 pages for calibration, settings, capacity
2019-09-09 1.70 fixed EEprom Read fail
    [Eeprom.c, main.c]
2019-09-12 1.73 LOG , ALSO FIXED CHARGE DISCHARGE BUGS
    [General.c, General.h, Menu.h, hd44780_driver.c, hd44780_driver.h, main.c]
2019-09-17 1.74 fixed log, added charge in LOG
    [General.c, General.h, Menu.h, main.c]
2019-10-28 1.79
    Added battery type
    Fixed infinity loop when off
    [Menu.h, main.c]
2019-10-29 PS 23V 3A v1.80 swing+Battery type menu
2019-10-29 PS 23V 3A v1.80 swing+Battery type menu1
2019-10-30 PS 23V 3A v2.00R - PreRelease
2019-10-31 PS 23V 3A v2.00R Battery capacity menu
2019-11-01 PS 23V 3A v2.00R - for tests
2019-11-04 PS 24V 3A v2.01R - adeed DELTA_UPS_BAT_MAX 5 //50mv
2019-11-08 PS 24V3.5A v2.02 FAN
2019-11-29 PS 24V3.5A v2.10 - added Key UP, Removed FAN
2019-11-29 PS 24V3.5A v2.10 - added Key UP, Removed FAN
2019-11-29 removed Eagle board
    [LCD&Control2PRNT.brd, LCD&ControlRev1.brd, LCD&ControlRev1.sch, LCD&ControlRev1Fix1.brd, LCD&ControlRev1Fix1.sch, LCD&ControlRev2.brd, LCD&ControlRev2.sch, Labels Denys.brd]
2020-02-12 fixed calibration values
2020-02-12 PS 22V2.5A v2.20 - added option "OUT after powerUp"
2020-03-07 PS 22V2.5A v2.40 added temperature of PowerBoard
2020-03-08 PS 22V2.5A v2.40. OFf when Temperature more then 85C
2020-03-09 PS+L 20V3A v2.41 - fix out of memory
    [General.c, General.h, main.c]
2020-08-28 v2.42 - fixed bugs. Passed smoke tests
    [main.c]
2020-11-09 PS+L 20V3A v2.50 - new filter. STM32CubeIDE
2020-11-25 v2.60 - fixed bugs. Passed smoke tests
    [PS2403L.ioc, main.c]
2021-02-18 PS+L 20V3A v2.61 - fixed stuck
    while (bufferUart1.tx_counter >= TX_BUFFER_SIZE-30); //если буфер переполнен, ждем
    [Eeprom.c, main.c, usart.c]
