jdmytrva/PowerSupply-BatteryCheking-PS2403L-/(notices)

Notices in the files:
PS2403L/Core/Src/main.c:
© Copyright (c) 2020 STMicroelectronics.
All rights reserved.
This software component is licensed by ST under BSD 3-Clause license,
the "License"; You may not use this file except in compliance with the
License. You may obtain a copy of the License at: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
(C) COPYRIGHT STMicroelectronics *****END OF FILE
parts and their libraries:
NXP_60_26022015: This library may be distributed and adapted freely for any purpose, as long as NXP is credited and any new creation is licensed under the same terms.
